ChrisNourse/halloween-leds/THIRD_PARTY_NOTICES.md

# Third-party notices and acknowledgments

## CURV LAB inspiration

Build-guide presentation inspired by [CURV LAB's WR1 Chassis Build Guide](https://www.curvlab.com/guides/wr1-build).

The landscape format, numbered operations and parts callouts informed this project's presentation. The assembly illustrations come from this project's CAD, and the instructions were written for Halloween LEDs. No CURV LAB PDF, illustrations or branding are included. This acknowledgment does not imply endorsement or grant rights to CURV LAB material.

## Adafruit Feather ESP32-S2 pinout

The artwork in `docs/build-guide/assets/references/adafruit-feather-esp32-s2-pinout.png` comes from the [Adafruit Feather ESP32-S2 PCB repository](https://github.com/adafruit/Adafruit-Feather-ESP32-S2-PCB). The upstream design credits Limor Fried/Ladyada for Adafruit Industries and uses [CC BY-SA 3.0 Unported](LICENSES/CC-BY-SA-3.0.txt).

The [original pinout PDF](https://github.com/adafruit/Adafruit-Feather-ESP32-S2-PCB/blob/main/Adafruit%20Feather%20ESP32-S2%20Pinout.pdf) was rendered as a full-page PNG at 4× resolution, with no labels changed. It is reproduced in the build-guide PDF and pin-reference SVG. Those embedded images retain CC BY-SA 3.0; they are excluded from the license for this project's original documentation. The [upstream README](docs/build-guide/assets/references/adafruit-feather-upstream-README.md) is preserved with its notices.

## Adafruit NeoPixel stick reference

The wiring documentation and build guide link to the [NeoPixel Stick 1426 product page and photographs](https://www.adafruit.com/product/1426). The product photograph is not included in this repository or embedded in the PDF.

## Software dependencies

CircuitPython, browser-test tooling and Python dependencies retain their own licenses. The project licenses cover this project's code, not separately supplied third-party packages. Preserve their notices when distributing those packages.
