ChrisNourse/halloween-leds/mechanical/previews/exploded.png

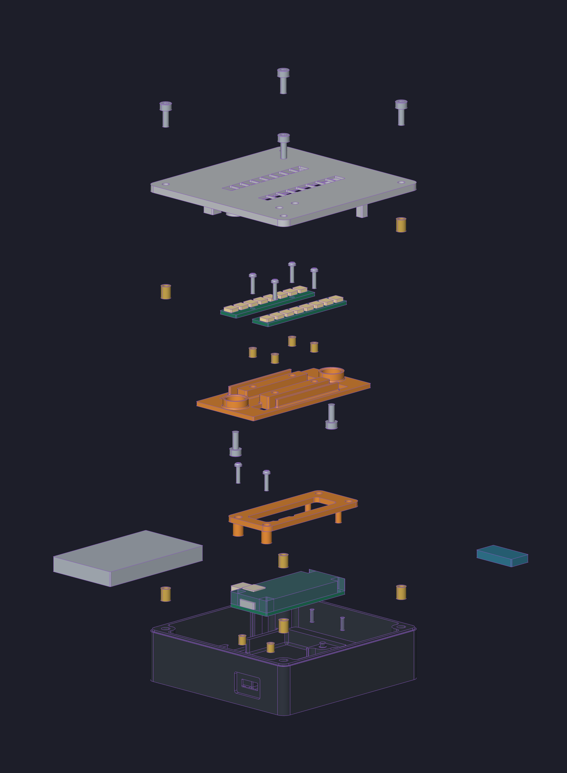
mechanical/previews/exploded.png
