ChrisNourse/halloween-leds/docs/build-guide/assets/assembled-1.dxf

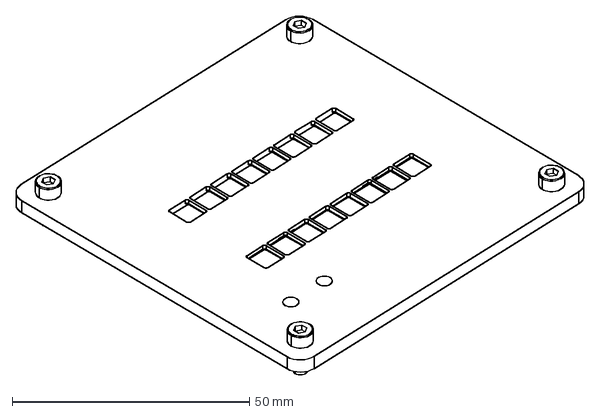
[picture p6: CAD file, 2026-10-22]
docs/build-guide/assets/assembled-1.dxf
119.7 x 75.6 mm
