ChrisNourse/halloween-leds/docs/build-guide/assets/led-mount-1.dxf

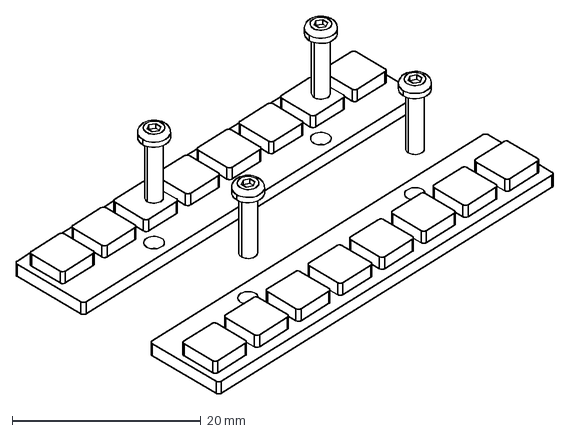
[picture p7: CAD file, 2026-10-22]
docs/build-guide/assets/led-mount-1.dxf
56.9 x 40.1 mm
