ChrisNourse/halloween-leds/mechanical/exports/stl/led-retainer.stl

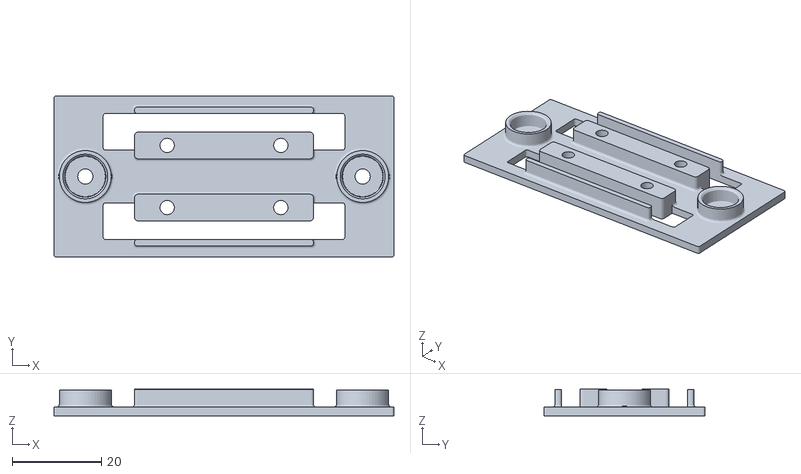
[picture p8: CAD file, 2026-10-22]
mechanical/exports/stl/led-retainer.stl
76.0 x 36.0 x 6.00
