ChrisNourse/halloween-leds/mechanical/exports/stl/base.stl

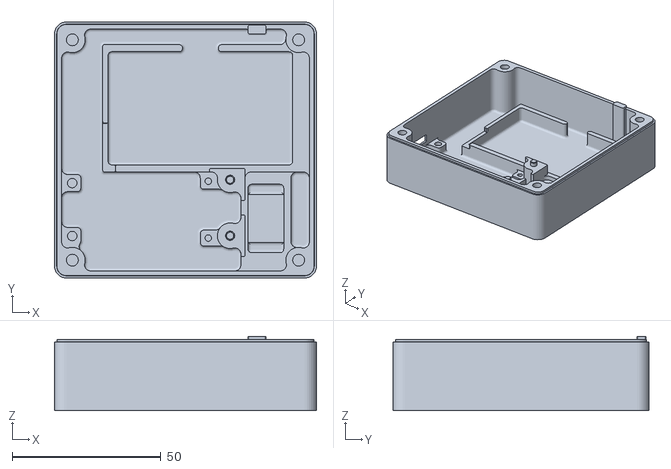
[picture p10: CAD file, 2026-10-22]
mechanical/exports/stl/base.stl
88.0 x 86.0 x 25.0
