ChrisNourse/halloween-leds/mechanical/exports/stl/faceplate.stl

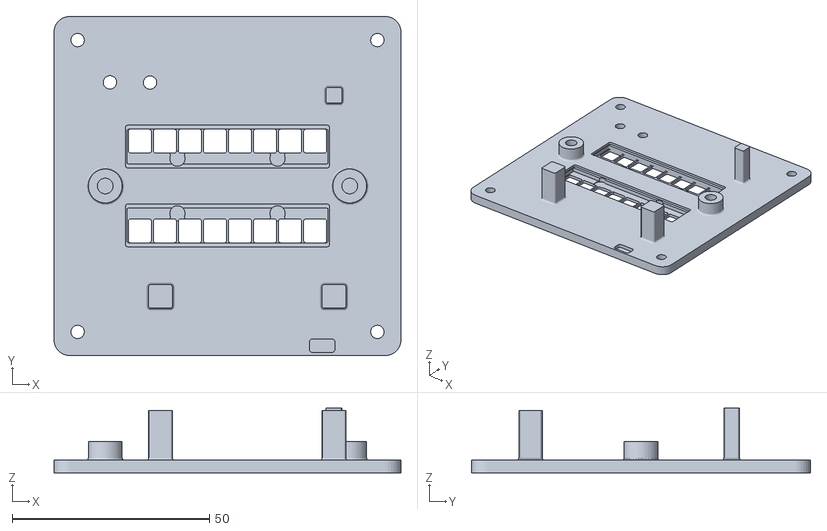
[picture p12: CAD file, 2026-10-22]
mechanical/exports/stl/faceplate.stl
88.0 x 86.0 x 16.4
