ChrisNourse/halloween-leds/docs/build-guide/assets/retainer-inserts-0.dxf

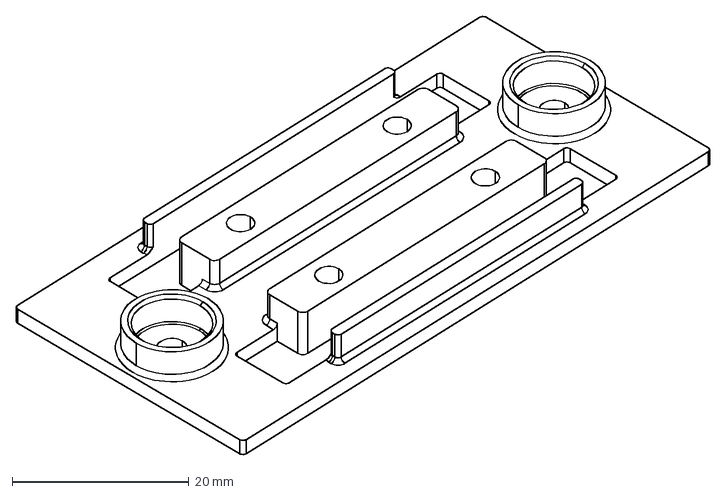
[picture p13: CAD file, 2026-10-22]
docs/build-guide/assets/retainer-inserts-0.dxf
78.4 x 49.5 mm
