ChrisNourse/halloween-leds/mechanical/exports/stl/feather-retainer.stl

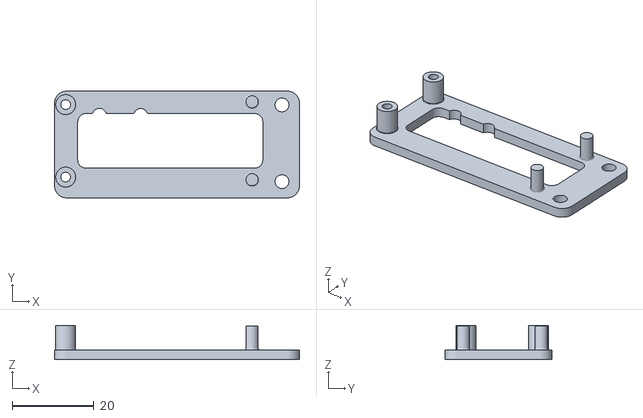
[picture p14: CAD file, 2026-10-22]
mechanical/exports/stl/feather-retainer.stl
60.1 x 26.2 x 8.40
