ChrisNourse/halloween-leds/docs/build-guide/assets/feather-1.dxf

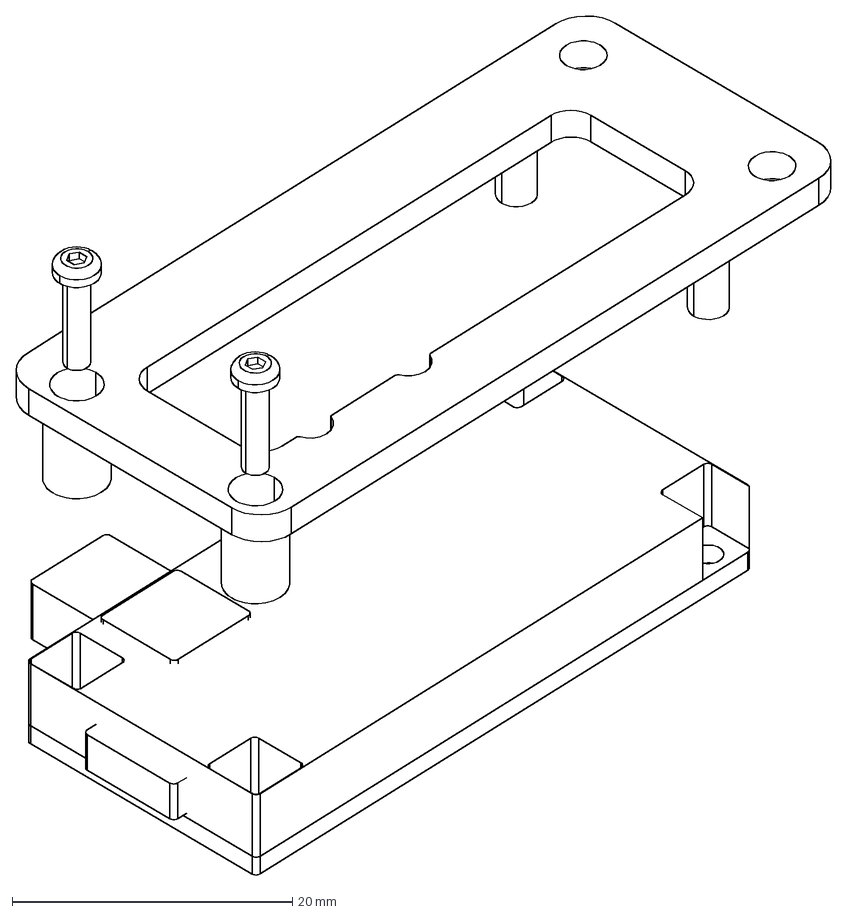
[picture p15: CAD file, 2026-10-22]
docs/build-guide/assets/feather-1.dxf
58.2 x 61.3 mm
