ChrisNourse/halloween-leds/docs/build-guide/assets/print-faceplate-0.dxf

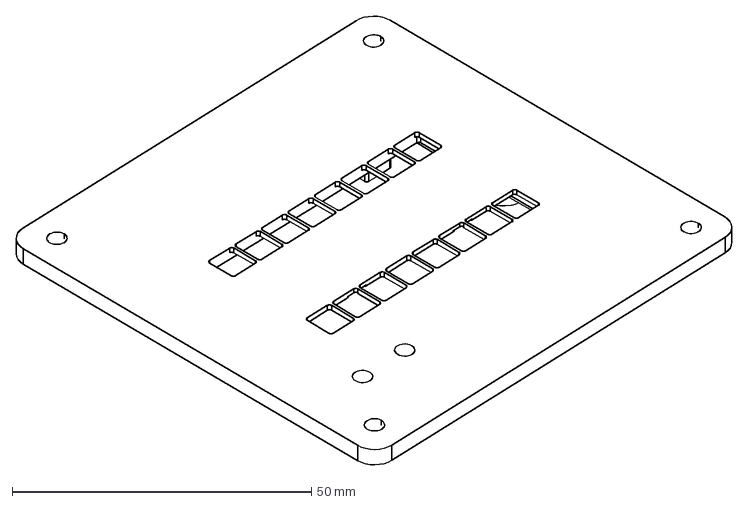
[picture p16: CAD file, 2026-10-22]
docs/build-guide/assets/print-faceplate-0.dxf
119.7 x 75.0 mm
