ChrisNourse/halloween-leds/docs/build-guide/assets/dowels-0.dxf

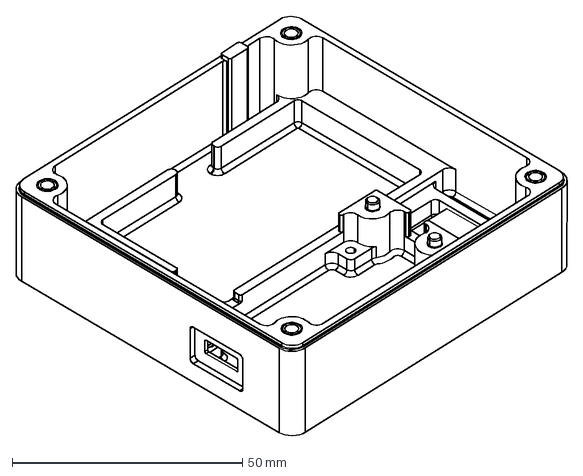
[picture p17: CAD file, 2026-10-22]
docs/build-guide/assets/dowels-0.dxf
119.7 x 91.1 mm
