ChrisNourse/halloween-leds/docs/build-guide/assets/base-inserts-1.dxf

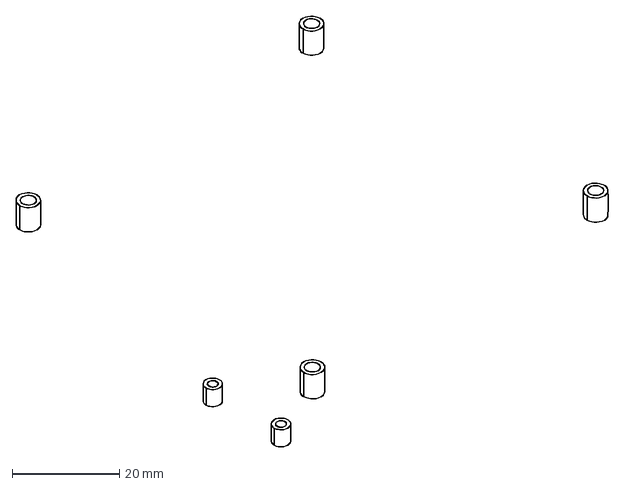
[picture p18: CAD file, 2026-10-22]
docs/build-guide/assets/base-inserts-1.dxf
110.6 x 80.5 mm
