ChrisNourse/halloween-leds/docs/build-guide/assets/battery-1.dxf

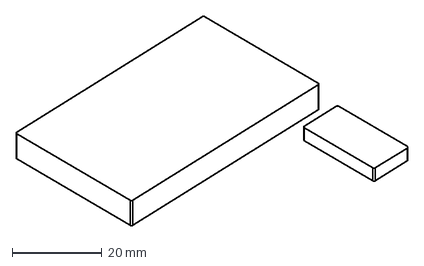
[picture p20: CAD file, 2026-10-22]
docs/build-guide/assets/battery-1.dxf
87.1 x 46.6 mm
