ChrisNourse/halloween-leds/docs/build-guide/assets/lid-inserts-1.dxf

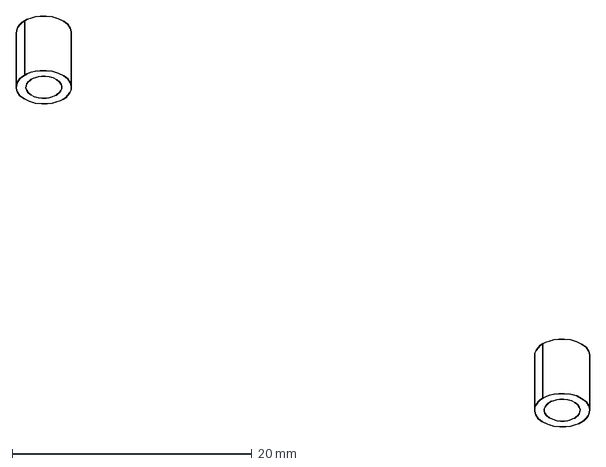
[picture p21: CAD file, 2026-10-22]
docs/build-guide/assets/lid-inserts-1.dxf
47.8 x 34.2 mm
