ChrisNourse/halloween-leds/docs/build-guide/assets/lid-mount-1.dxf

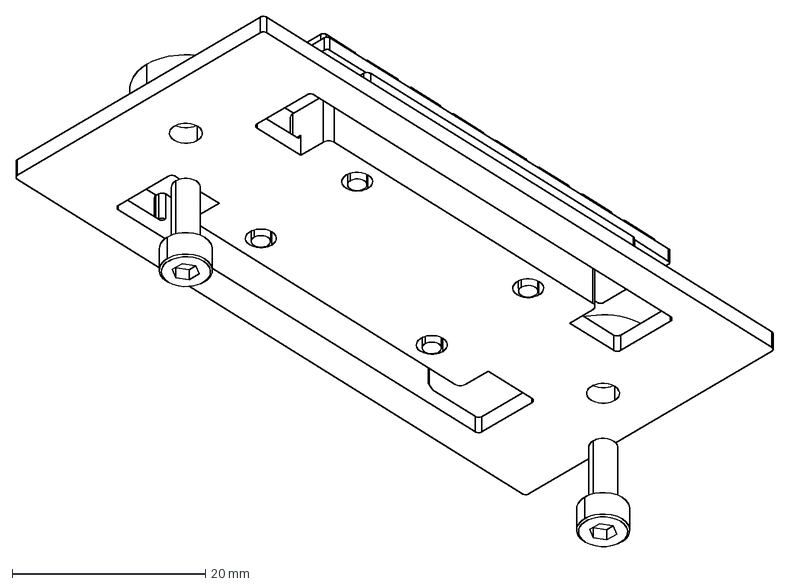
[picture p22: CAD file, 2026-10-22]
docs/build-guide/assets/lid-mount-1.dxf
78.4 x 54.9 mm
