ChrisNourse/halloween-leds/docs/build-guide/assets/close-1.dxf

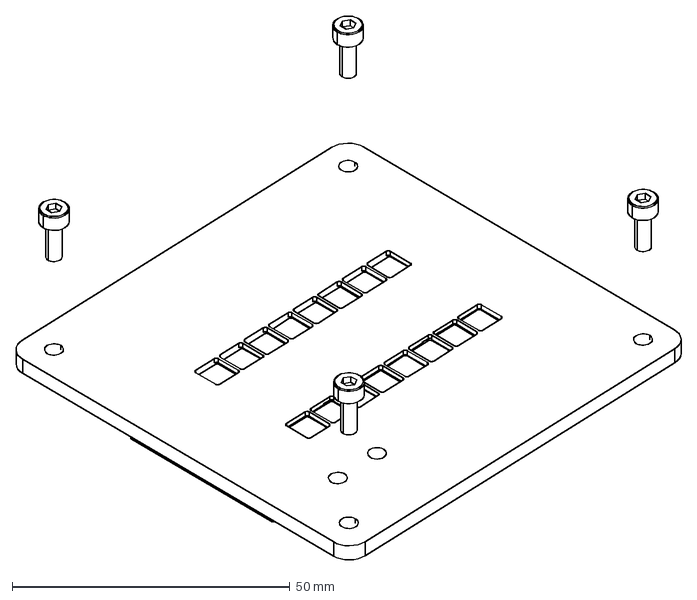
[picture p23: CAD file, 2026-10-22]
docs/build-guide/assets/close-1.dxf
119.7 x 97.9 mm
