ChrisNourse/halloween-leds/docs/build-guide/assets/lid-inserts-0.dxf

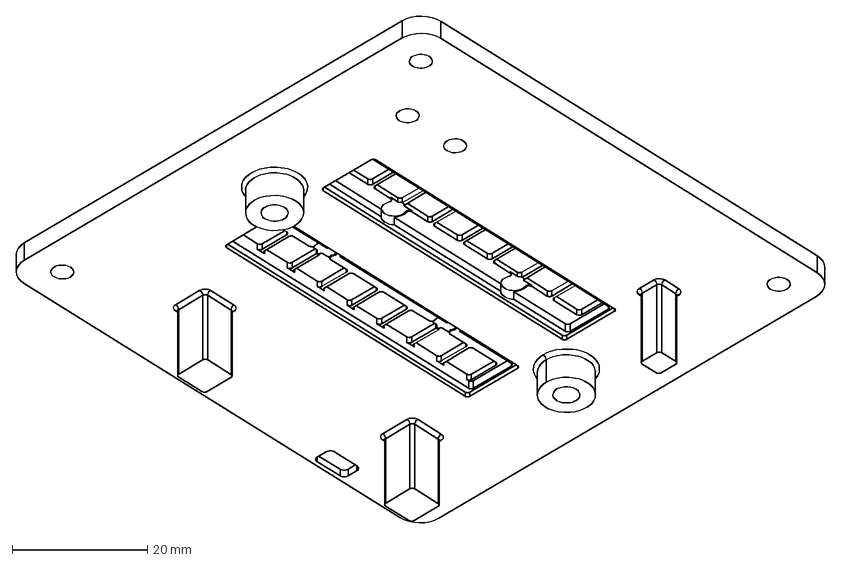
[picture p24: CAD file, 2026-10-22]
docs/build-guide/assets/lid-inserts-0.dxf
119.7 x 75.0 mm
