ChrisNourse/halloween-leds/docs/build-guide/assets/retainer-inserts-1.dxf

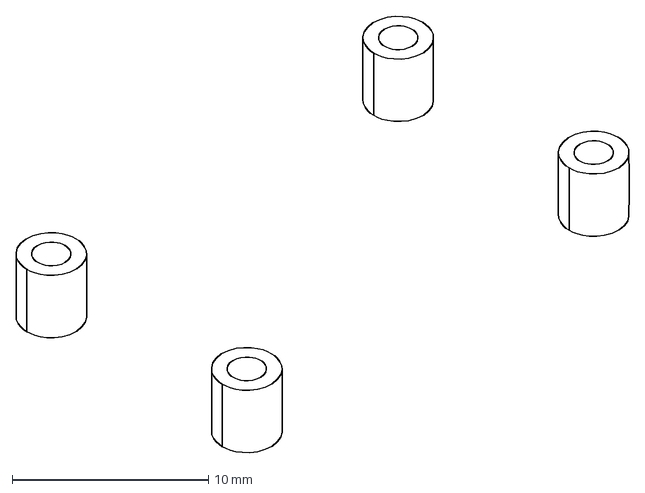
[picture p25: CAD file, 2026-10-22]
docs/build-guide/assets/retainer-inserts-1.dxf
31.3 x 22.2 mm
