ChrisNourse/halloween-leds/docs/build-guide/assets/print-feather-retainer-0.dxf

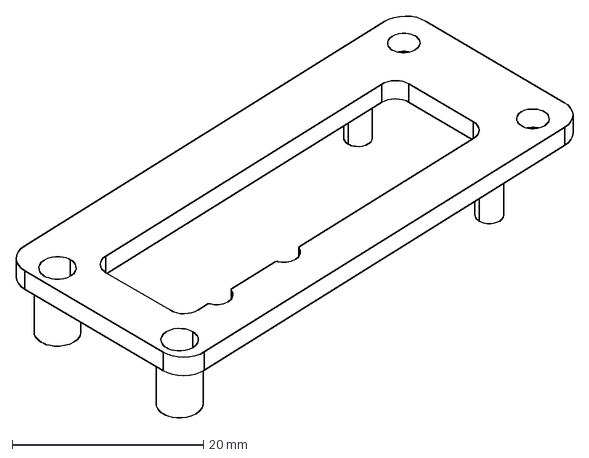
[picture p26: CAD file, 2026-10-22]
docs/build-guide/assets/print-feather-retainer-0.dxf
58.2 x 42.0 mm
