ChrisNourse/halloween-leds/docs/build-guide/assets/dowels-1.dxf

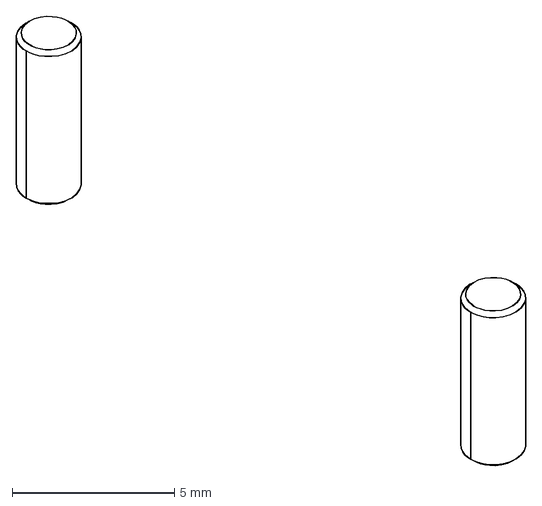
[picture p28: CAD file, 2026-10-22]
docs/build-guide/assets/dowels-1.dxf
15.7 x 13.9 mm
