ChrisNourse/halloween-leds/docs/Halloween-LEDs-Build-Guide.pdf

## Halloween LEDs

Build guide · v0.9.3 experimental
A small light you can build, program and modify.

### Two RGB LED sticks. Battery power. Local browser controls. Four printed parts with editable SolidCraft

sketches and operations.

Final CAD handoff · 294cd1f
Assembly illustrations and four printable STLs match the saved mechanical design from 22 October 2026. Digital mesh checks pass. Hardware qualification is in progress; v0.9.3 is experimental.

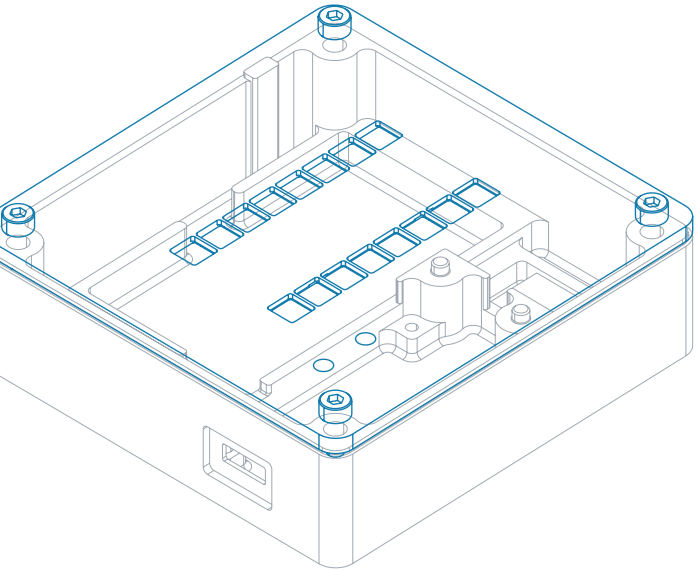
[picture p31: figure]

Build-guide presentation inspired by CURV LAB's WR1 Chassis Build Guide. (https://www.curvlab.com/guides/wr1-build) Assembly illustrations come from this project's own CAD.

Halloween LEDs / v0.9.3 experimental / CAD 294cd1f · 22 Oct 2026 | 01

## 0.1 Before you begin

### 01 Read the electrical steps before soldering. Keep USB and the

battery disconnected while wiring or fitting hardware.

### 02 Use a multimeter to verify polarity, shorts and boost output. The

installed boost arrived at 12 V and required removal of two selection resistors.

### 03 Print the four supplied enclosure parts. Gather the listed

electronics and hardware before starting assembly.

## Tools

PETG printer and slicer
Temperature-controlled soldering iron M2/M3 heat-set tips or suitable insertion tool Multimeter, flush cutters and wire stripper 2.5 mm and 1.3 mm hex drivers
Calipers, tweezers, heat-shrink tubing USB-C data cable and computer

Physical fit, temperature rise, battery runtime and cutoff behavior remain to be qualified. Use indoors: the enclosure has no weatherproof rating. Keep a LiPo pouch free of sharp edges, pinching and screw tips.

Halloween LEDs / v0.9.3 experimental / CAD 294cd1f · 22 Oct 2026 | 02

## 0.2 Electronics shopping list

Quantities are per completed light; product names link to their sources.

1× | ESP32-S2 Feather · Adafruit 5000 (https://www.adafruit.com/product/5000)
| Use this exact board, not another Feather footprint.
2× | 8-pixel RGB NeoPixel stick · Adafruit 1426 (https://www.adafruit.com/product/1426)
| RGB / GRB data; do not substitute the RGBW version.
1× | 3.7 V 2000 mAh LiPo · Adafruit 2011 (https://www.adafruit.com/product/2011)
| Feather-compatible JST polarity; verify replacement packs.
1× | TMF002 boost module · Teyleten Robot (https://www.amazon.com/dp/B0B4TB9QNY)
| Installed board: remove two selection resistors for 5 V; see step 4.3.

Also needed: flexible insulated hookup wire sized for the measured LED load, solder, heat-shrink, a thin nonconductive battery pad and a USB-C data cable. Wire lengths depend on routing; leave service slack without crossing screw posts.

Halloween LEDs / v0.9.3 experimental / CAD 294cd1f · 22 Oct 2026 | 03

## 0.3 Fasteners and printed parts

Hardware quantities below include every modeled screw, insert and dowel.

6× | M3 × 8 socket-head screw (https://www.amazon.com/s?k=stainless+M3+socket+head+screw+assortment) 4 close the case; 2 attach the LED frame. 2.5 mm hex.
6× | M2 × 8 button-head screw (https://www.amazon.com/s?k=stainless+M2+button+head+screw+assortment) 4 hold LED boards; 2 hold Feather frame. 1.3 mm hex.
6× | Ruthex RX-M3×5.7 insert (https://www.ruthex.de) 4 in base; 2 in faceplate.
6× | Ruthex RX-M2×4 insert (https://www.ruthex.de) 4 in LED retainer; 2 in base.
2× | 2 × 6 mm metal dowel (https://www.amazon.com/s?k=stainless+2mm+dowel+pin+assortment) Locate the Feather on the opposite side from its screws.

Ordinary assortment packs
The original build used Amazon stainless screw and dowel mix packs. Choose the sizes listed here and check that screw heads fit the recesses.

Print one each
Base
Faceplate
LED retainer
Feather retainer
Ruthex M3 inserts (https://www.ruthex.de/products/ruthex-gewindeeinsatz-m3-100-stuck-rx-m3x5-7-messing-gewindebuchsen) | Ruthex M2 inserts (https://www.ruthex.de/collections/gewindeeinsatze/products/ruthex-gewindeeinsatz-m2-70-stuck-rx-m2x4-messing-gewindebuchsen) | 2 × 6 mm dowels (https://www.amazon.com/s?k=stainless+2mm+dowel+pin+assortment)

Screw and dowel links open Amazon searches for assortment packs. No particular brand is required.

Halloween LEDs / v0.9.3 experimental / CAD 294cd1f · 22 Oct 2026 | 04

## 1.0 Print and inspect the four parts

PETG · 0.4 mm nozzle · 0.20 mm layers · 4 perimeters · supports off

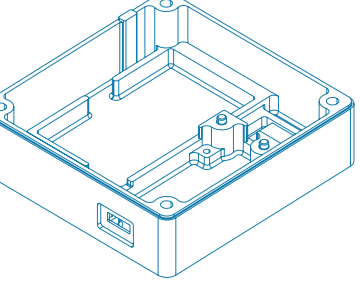
[picture p32: figure]

Base

Flat underside down; cavity up.

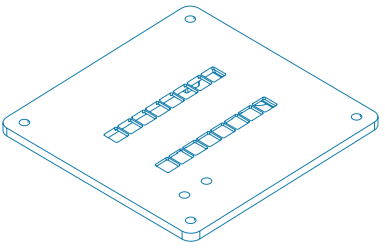
[picture p33: figure]

Faceplate

Exterior LED face down; posts up.

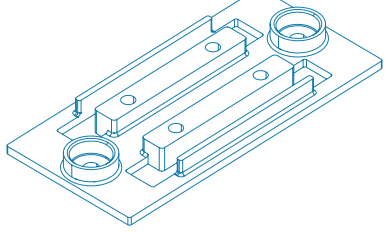
[picture p34: figure]

LED retainer

Broad frame down; PCB rails up.

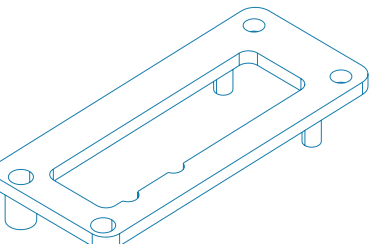
[picture p35: figure]

Feather retainer

Broad top face down; sleeves up.

Drawings identify parts; orient them as described in your slicer. Use your tested PETG material profile. All parts fit a 180 × 180 mm bed. Inspect USB bridging, insert holes and thin screw wells. Remove strings and burrs without altering bearing faces.

Halloween LEDs / v0.9.3 experimental / CAD 294cd1f · 22 Oct 2026 | 05

## 2.0 Heat-set the base inserts

Gray: existing parts / Blue: parts added in this step / Exploded spacing is illustrative

### 2.1 Install four M3 inserts in the corner

closure posts.

### 2.2 Install two M2 inserts in the USB-side

Feather support pads.

### 2.3 Seat every insert flush and square. Let

the plastic cool completely before adding electronics.

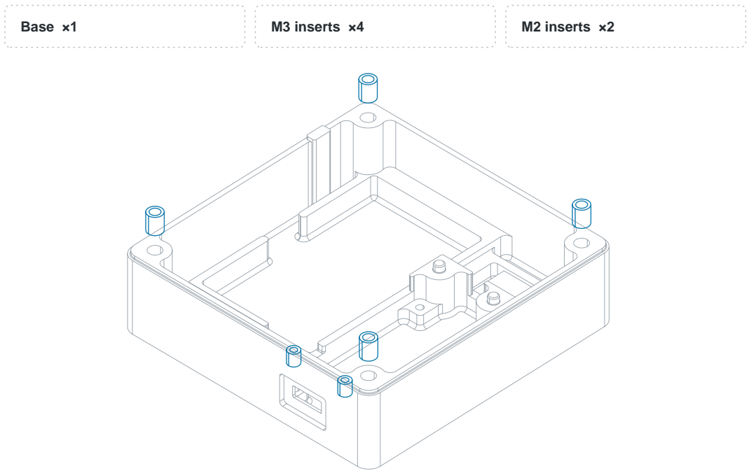
[picture p36: figure]
Base ×1; M3 inserts ×4; M2 inserts ×2

The four tall corner posts take M3; the two lower USB-side pads take M2. Inserts are lifted for clarity.

Halloween LEDs / v0.9.3 experimental / CAD 294cd1f · 22 Oct 2026 | 06

## 2.4 Heat-set the faceplate inserts

Gray: existing parts / Blue: parts added in this step / Exploded spacing is illustrative

Faceplate ×1 | M3 inserts ×2

### 2.4 Turn the faceplate over. Insert one M3

insert into each of the two underside retainer bosses.

### 2.5 Keep the iron square. Stop at flush; do

not push through the blind roof.

### 2.6 Let both bosses cool before fitting the

LED frame.

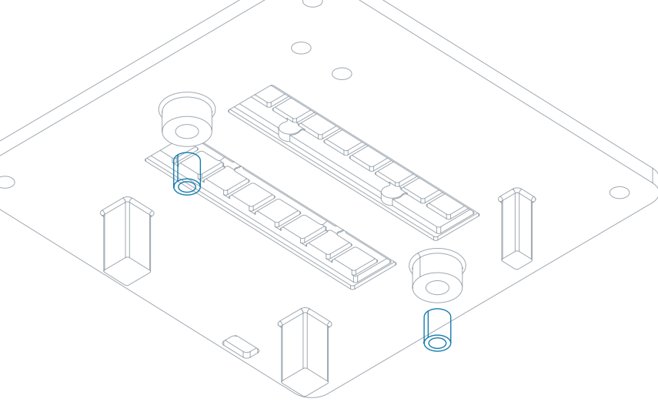
[picture p37: figure]

Underside view. These two inserts attach the LED retainer; the four corner holes are case screw clearances.

Halloween LEDs / v0.9.3 experimental / CAD 294cd1f · 22 Oct 2026 | 07

## 3.0 Prepare the LED retainer

Gray: existing parts / Blue: parts added in this step / Exploded spacing is illustrative

LED retainer ×1 | M2 inserts ×4

### 3.1 Heat-set four M2 inserts into the

frame’s PCB mounting pockets.

### 3.2 Seat them flush with the PCB support

surface. These pockets are open through the frame, with no bottom stop.

### 3.3 Inspect the support rails and clear any

debris before placing a board.

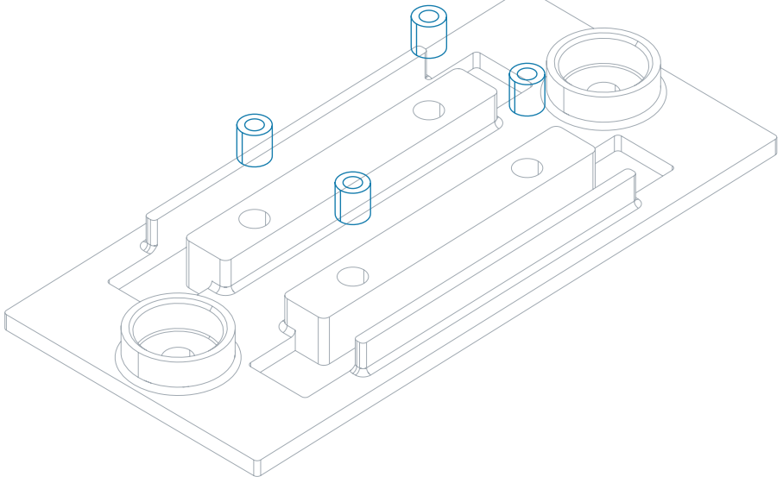
[picture p38: figure]

The locating collars and PCB rails are integral parts of the printed LED retainer.

Halloween LEDs / v0.9.3 experimental / CAD 294cd1f · 22 Oct 2026 | 08

## 3.4 Mount the two LED sticks

Gray: existing parts / Blue: parts added in this step / Exploded spacing is illustrative

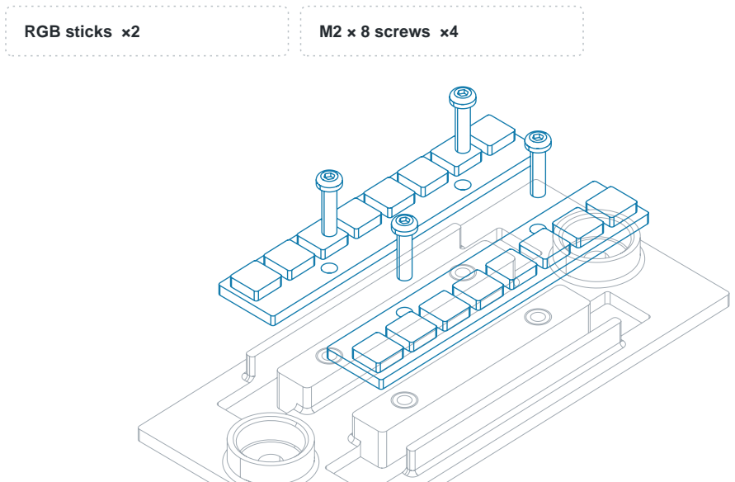
[picture p39: figure]
RGB sticks ×2; M2 × 8 screws ×4

### 3.4 Prepare the wires while both sides of

the boards are accessible. Identify DIN, DOUT, 5V and GND from the actual silkscreen.

### 3.5 Place both boards with LEDs facing

outward and mounting-hole edges facing inward. The two sticks face opposite directions.

3.6 Fit four M2 × 8 button-head screws. Tighten gently onto the mounting pads.

Data direction follows DIN/DOUT, not the mechanical left/right orientation. Screw tips project about 0.4 mm below the retainer.

Halloween LEDs / v0.9.3 experimental / CAD 294cd1f · 22 Oct 2026 | 09

## 3.7 Attach the LED assembly to the lid

Gray: existing parts / Blue: parts added in this step / Exploded spacing is illustrative

Lid assembly ×1 | LED assembly ×1 | M3 × 8 screws ×2

### 3.7 Place the LEDs into the faceplate

recesses from underneath.

### 3.8 Align the retainer collars with the lid

bosses. Keep solder joints and leads clear of the bearing surfaces.

3.9 Fit two M3 screws from the underside. Check that every LED lines up with its aperture.

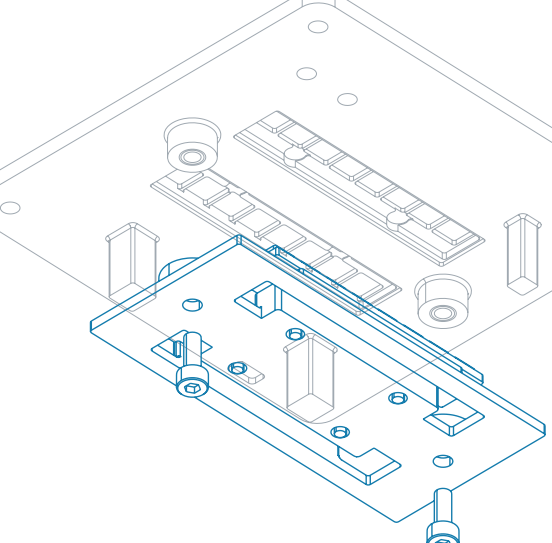
[picture p40: figure]

Underside view. Install the four LED-board screws first: the faceplate covers their heads once assembled.

Halloween LEDs / v0.9.3 experimental / CAD 294cd1f · 22 Oct 2026 | 10

## 4.0 Wire power and data

Recommended wiring: move boost input from the reported 3V connection to BAT. Power off before rework.

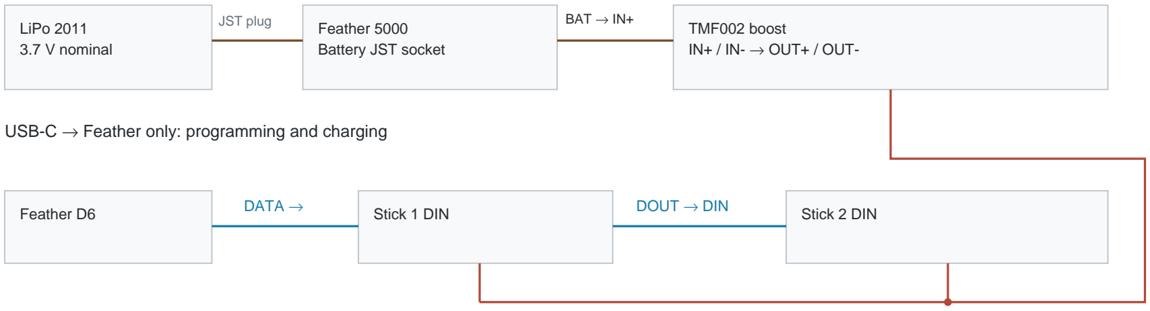
[picture p41: figure]
LiPo 2011 3.7 V nominal; Feather 5000 Battery JST socket; JST plug; TMF002 boost; IN+ / IN- → OUT+ / OUT-; BAT → IN+

USB-C → Feather only: programming and charging

Feather D6 | Stick 1 DIN | Stick 2 DIN DATA → | DOUT → DIN

BOOST OUT+ = measured 5 V → both stick 5V pads

COMMON GND: Feather GND + boost IN- / OUT- + both stick GND pads

Recommended BAT-fed topology; input rework is pending. D6 connects directly to DIN; no extra level shifter or bulk capacitor is installed. For a more robust 5 V data interface, see the next page. Never connect boost OUT+ to Feather BAT, 3V or USB 5V.

Halloween LEDs / v0.9.3 experimental / CAD 294cd1f · 22 Oct 2026 | 11

4.0a Feather ESP32-S2 pinout Adafruit PrettyPins artwork. USB-C at the top; match the labels on your board.

### Our connections

VBAT / BAT
Boost IN+

GND
Common ground

D6 / GPIO6
First stick DIN

USB-C
Program and charge

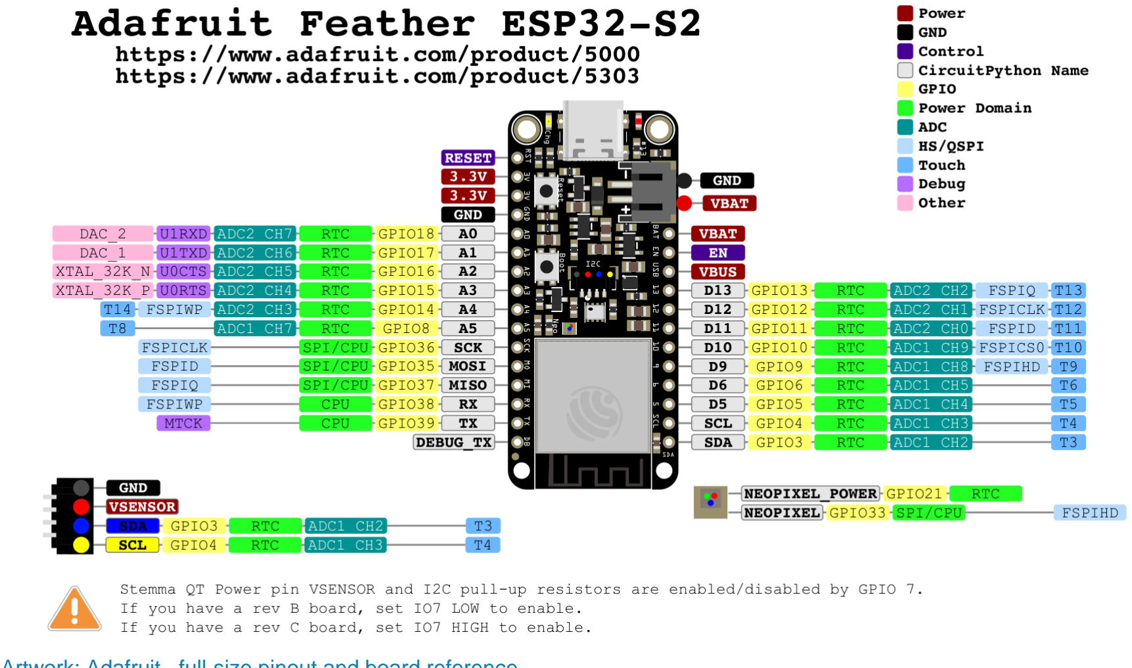
[picture p42: figure]

Artwork: Adafruit · full-size pinout and board reference (https://learn.adafruit.com/adafruit-esp32-s2-feather/pinouts)
CC BY-SA 3.0 · full page rendered to PNG; labels unchanged (https://creativecommons.org/licenses/by-sa/3.0/)
Halloween LEDs / v0.9.3 experimental / CAD 294cd1f · 22 Oct 2026 | 12

4.0b NeoPixel stick solder pads Use the labels on your board to identify each connection.

### View the board reference

Adafruit NeoPixel Stick 1426: product page and photos (https://www.adafruit.com/product/1426)

Open the product page to view the rear / solder-side photograph. With the printed label upright, DOUT is at the left-hand end and DIN at the right-hand end. Verify the actual silkscreen before soldering.

The two sticks receive power in parallel and data in sequence. Turning a stick around in the enclosure does not change which pad is DIN.

### Read the printed pad labels

DIN
Stick 1: connect to Feather D6. Stick 2: connect to stick 1 DOUT.

DOUT
Stick 1: connect to stick 2 DIN.
Stick 2: leave unconnected.

5VDC and GND
Both sticks share regulated 5 V and common ground. Each end has two GND pads.

www.adafruit.com/product/1426

Halloween LEDs / v0.9.3 experimental / CAD 294cd1f · 22 Oct 2026 | 13

4.0c Removable LED harness: details pending The installed JST connection lets the top plate unplug without dismantling the base.

## Service the top plate

### 1 Disconnect USB and battery power before unplugging the LED

harness.

2 Support the top plate. Separate the connector by its housings, without pulling the wires.

### 3 Allow service slack and keep wires clear of screws and mating

surfaces. Final routing and access photos are pending.

### To complete after the design is finalized

TBD: connector
JST family, pitch, contact count, mating parts and purchase link.

TBD: pinout and harness
Numbered mating-face drawing with latch orientation; wire colors, gauge, lengths and strain relief.

TBD: electrical checks
Boost resistor photo, final signal-conditioning parts, load current, temperature and runtime. TPS61023 replacement remains untested.

TBD is not a wiring instruction. The LED assembly requires 5 V, ground and data; connector cavity assignments are not yet recorded. See docs/wiring.md for the editable completion checklist.

Halloween LEDs / v0.9.3 experimental / CAD 294cd1f · 22 Oct 2026 | 14

## 4.1 Recommended signal conditioning

These additional parts are not included in the enclosure’s current fit validation.

Feather D6
3.3 V data

74AHCT125
5 V powered

300–500 Ω
series resistor

Stick 1 DIN

74AHCT125, channel 1 (14-pin package)
Pin 14 VCC → regulated 5 V; pin 7 → common GND.
Pin 1 /OE → GND; pin 2 A → Feather D6.
Pin 3 Y → resistor → first stick DIN.
Add 0.1 µF decoupling at VCC/GND. Disable unused channels and tie unused inputs to defined levels; verify your exact device pinout.

Pixel power
Adafruit recommends a 500–1000 µF capacitor across LED 5 V and GND. Use a voltage rating of at least 6.3 V and observe polarity. Place the series resistor near the first pixel.

Plan an insulated mounting location before adding these parts. Recheck enclosure clearance; do not leave bare circuitry against the battery.

Adafruit NeoPixel best practices (https://learn.adafruit.com/adafruit-neopixel-uberguide/best-practices) | TI SN74AHCT125 pinout and decoupling (https://www.ti.com/lit/ds/symlink/sn74ahct125.pdf)
Halloween LEDs / v0.9.3 experimental / CAD 294cd1f · 22 Oct 2026 | 15

## 4.2 Measure before connecting the LEDs

### 4.2 With battery and USB unplugged, check polarity and inspect every solder

joint. Check for unintended shorts between supply and ground.

### 4.3 The installed TMF002 needed two voltage-selection resistors desoldered to

change 12 V to 5 V. Identify them from instructions for your exact board revision before removal; positions are not documented here.

### 4.4 Keep the LED 5 V leads disconnected. Power the boost from Feather BAT

and GND, then measure OUT+ against OUT-.

4.5 Proceed only when the output is approximately 5 V with correct polarity. Disconnect power again before joining the LED supply leads.

Multimeter
DC volts
Red probe | Black probe
OUT+ | OUT-

Do not use the Feather 3V regulator to power the boost. The boost is not a battery charger; the battery charges through the Feather.

Halloween LEDs / v0.9.3 experimental / CAD 294cd1f · 22 Oct 2026 | 16

## 5.0 Fit the Feather locating dowels

Gray: existing parts / Blue: parts added in this step / Exploded spacing is illustrative

Base assembly ×1 | 2 × 6 mm dowels ×2

### 5.1 Test each dowel in the two small PCB

locating holes, opposite the USB side.

### 5.2 The revised bores are nominally 2.2

mm. They should accept the 2 mm dowels without cracking the pads.

### 5.3 If loose, use a small amount of

adhesive below the bearing surface. Keep the board removable and the pad tops clean.

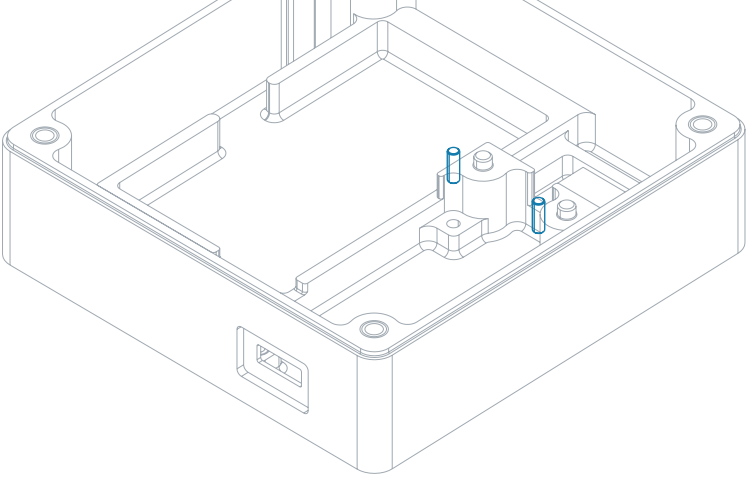
[picture p43: figure]

Seated dowels project 1.8 mm above the PCB supports. Do not hammer dowels into the printed base.

Halloween LEDs / v0.9.3 experimental / CAD 294cd1f · 22 Oct 2026 | 17

## 5.4 Mount the controller and frame

Gray: existing parts / Blue: parts added in this step / Exploded spacing is illustrative

Feather ×1 | Feather frame ×1 | M2 × 8 screws ×2

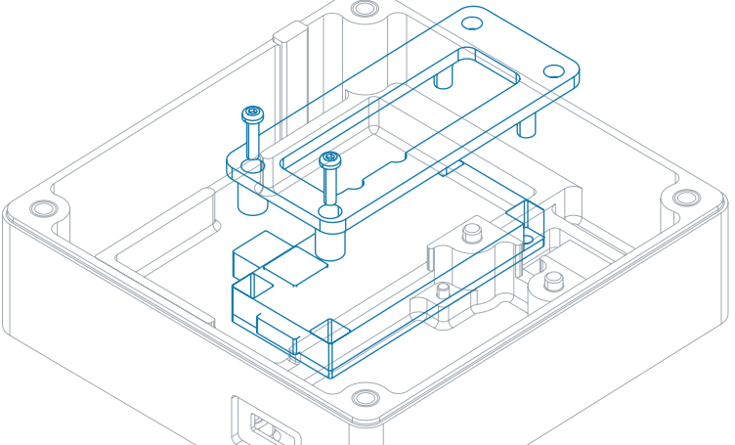
[picture p44: figure]

### 5.4 Fit the Feather over the dowels with

USB-C facing the case opening.

### 5.5 For final mounting, connect the

prepared battery plug before the frame blocks access. Keep all exposed connections insulated.

### 5.6 Seat the frame on its two opposite

locating posts. Fit two M2 screws through the USB-side access wells; tighten gently.

The frame clamps the PCB mounting pads. Check the 1.3 mm driver reaches both recessed heads without rubbing the wells.

Halloween LEDs / v0.9.3 experimental / CAD 294cd1f · 22 Oct 2026 | 18

## 5.7 Seat the battery and boost

Gray: existing parts / Blue: parts added in this step / Exploded spacing is illustrative

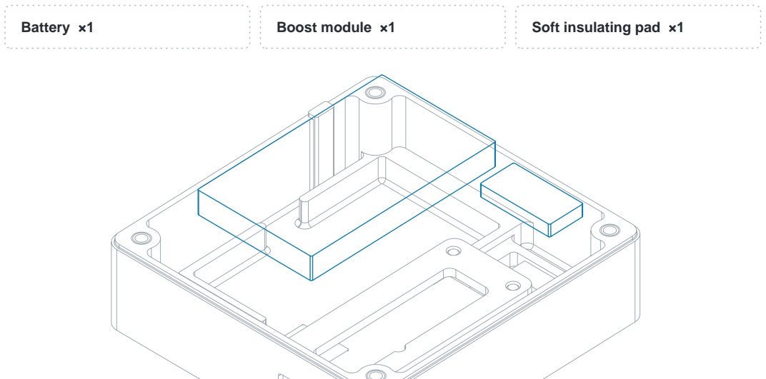
[picture p45: figure]
Battery ×1; Boost module ×1; Soft insulating pad ×1

### 5.7 Place the boost on its insulating seat

inside the small cradle. Keep joints and leads clear of the lid stop.

### 5.8 Place the battery in its bay on a 1 mm

soft nonconductive pad. Do not compress or puncture the pouch.

### 5.9 Route the battery lead beside the bay

and away from the inserts. Leave enough slack to open the lid without pulling a solder joint.

Battery and boost use cradles and lid stops, not separate screw clamps. Actual wire bends and connector fit require checking.

Halloween LEDs / v0.9.3 experimental / CAD 294cd1f · 22 Oct 2026 | 19

## 6.0 Install the firmware before closing the case

### 6.1 Install CircuitPython for the Adafruit ESP32-S2 Feather. Follow the

board’s runtime installation guide.

### 6.2 Copy settings.example.toml to a private location. Enter your 2.4 GHz

Wi-Fi details and a unique OTA password.

### 6.3 Set LATITUDE, LONGITUDE and TIMEZONE in your private

settings.toml. Defaults are San Francisco. For another location, change all three: quoted decimal degrees and an IANA timezone.

### 6.4 Install from the repository root. Tap RESET afterward to apply the

USB configuration.

## USB install

uv run scripts/device.py inspect

uv run scripts/device.py install --settings /private/path/settings.toml

Run the install command on one line. On systems other than macOS, pass --volume /path/to/CIRCUITPY. The installer verifies the board and copies files with readback checks.

CircuitPython for the exact Feather board (https://circuitpython.org/board/adafruit_feather_esp32s2/)

Install uv on your computer (https://docs.astral.sh/uv/getting-started/installation/)

Halloween LEDs / v0.9.3 experimental / CAD 294cd1f · 22 Oct 2026 | 20

## 6.5 Run the first lighting check

### 6.5 Power the open assembly. Check the boost voltage under load and look for

heating or unstable output. Start at low brightness.

### 6.6 Open http://halloween.local on the same local network. If name discovery

fails, use http:// followed by the board IP from your router.

### 6.7 Disable Sunset schedule for this manual check. Select a solid color at

10–15% brightness; test red, green and blue.

6.8 Confirm all 16 pixels respond and the second stick follows the first. Re-enable the schedule when ready.

## If nothing lights

Press BOOT if daytime sleep has turned off Wi-Fi and the website.

Check common ground, boost output and DIN/DOUT direction. If only one stick works, check the first DOUT to second DIN link.

For flicker or wrong colors, check power stability, GRB/RGB selection and the recommended level shifter.

Higher brightness increases load. The converter’s continuous rating, enclosed temperature and battery runtime are not yet measured.

Halloween LEDs / v0.9.3 experimental / CAD 294cd1f · 22 Oct 2026 | 21

## 7.0 Close the enclosure

Gray: existing parts / Blue: parts added in this step / Exploded spacing is illustrative

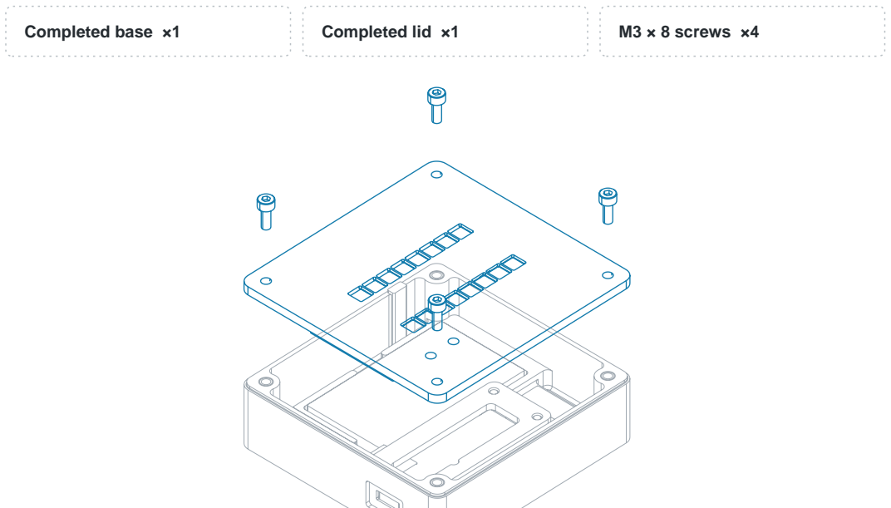
[picture p46: figure]
Completed base ×1; Completed lid ×1; M3 × 8 screws ×4

### 7.1 Remove USB power and disconnect

the battery before arranging wires or closing the case.

### 7.2 Check full USB plug insertion, free wire

bends and battery clearance. Reconnect the battery only after routing is secure.

### 7.3 Match the lid orientation key. Lower the

lid without force, then fit four M3 screws evenly. Stop if the seam will not close freely.

Do not use the screws to pull a fouling lid into place. No wire, pouch or solder joint should sit between bearing surfaces.

Halloween LEDs / v0.9.3 experimental / CAD 294cd1f · 22 Oct 2026 | 22

## 7.4 Final checks and future changes

### 7.4 Confirm USB charging access and the BOOT / RESET pinholes. Use a

suitable blunt probe; do not force it.

### 7.5 Test saved settings after a reset. Check manual blackout, browser

reconnect and operation without a computer attached.

### 7.6 Observe the first full sunset/sunrise cycle and monitor temperature

during the intended use. Record battery runtime before relying on it.

## Modify the native design

Open mechanical/cad/enclosure.solidcraft with its sibling part files and hardware folder intact.

Edit named sketches, driving dimensions and feature operations in the source part. Save it, update its link in the assembly and check mating features.

Regenerate affected STLs after every geometry change. Print files are derivatives; the organized native history remains the editable design.

CAD and four STL exports are synchronized and digitally checked. Hardware qualification is in progress for v1.0.0; results remain unrecorded.

Halloween LEDs / v0.9.3 experimental / CAD 294cd1f · 22 Oct 2026 | 23

## Licenses and credits

Copyright 2026 Halloween LEDs contributors. Original guide text and illustrations: CC BY-SA 4.0. (https://creativecommons.org/licenses/by-sa/4.0/) Credit the contributors, link to the source and license, and identify changes when sharing adaptations.

Original software: GPL-3.0-only. Hardware design sources and exports: CERN-OHL-S-2.0. See LICENSE.md and LICENSES/ in the source repository for the scope and full terms. Third-party assets retain their own terms.

Feather pinout: Adafruit Industries; upstream design credited to Limor Fried/Ladyada. CC BY-SA 3.0. (https://creativecommons.org/licenses/by-sa/3.0/) Full pinout page rendered to PNG; labels unchanged. Upstream notices are preserved in the source repository.

NeoPixel Stick reference: Adafruit product 1426. (https://www.adafruit.com/product/1426) Product photographs are available on Adafruit's website; they are not reproduced in this guide.

Presentation inspired by CURV LAB's WR1 Chassis Build Guide. (https://www.curvlab.com/guides/wr1-build) Assembly illustrations and instructions were created for Halloween LEDs. See THIRD_PARTY_NOTICES.md for source links and details.

Halloween LEDs / v0.9.3 experimental / CAD 294cd1f · 22 Oct 2026 | 24
